XRobots/openDog/Part1/CAD/DogV3.stp

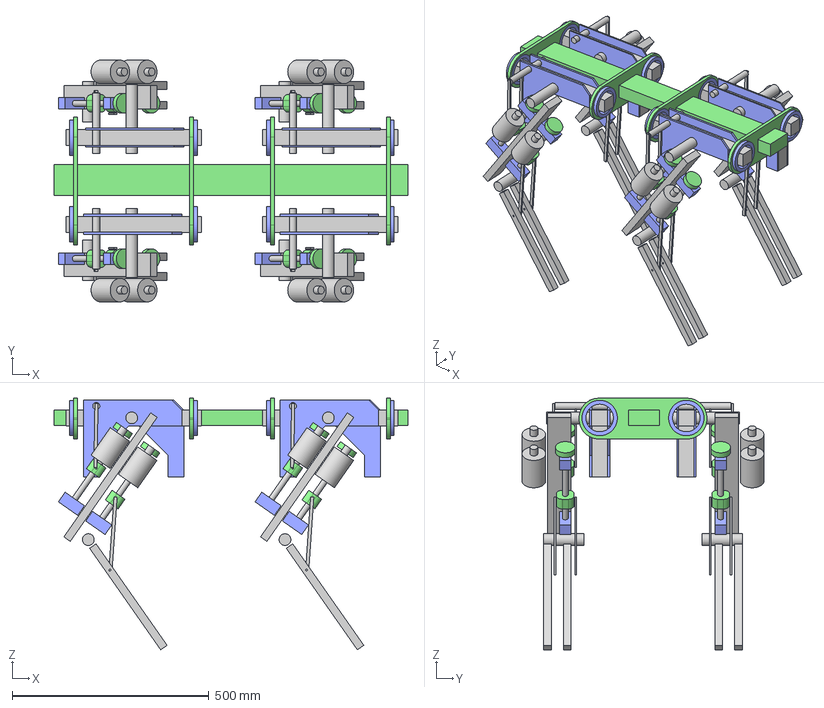
[picture p1: CAD file, 2018-05-31]
Part1/CAD/DogV3.stp
900.0 x 615.0 x 639.7 mm
slider1 x 2
slider2 x 2
lower leg x 2
hip x 2
rod2 x 2
rod1 x 2
slider1(Mirror) (1) x 2
slider2(Mirror) (1) x 2
lower leg(Mirror) (3) x 2
hip(Mirror) (3) x 2
rod2(Mirror) (1) x 2
rod1(Mirror) (1) x 2
