XRobots/openDog/Part10/bone3.stl

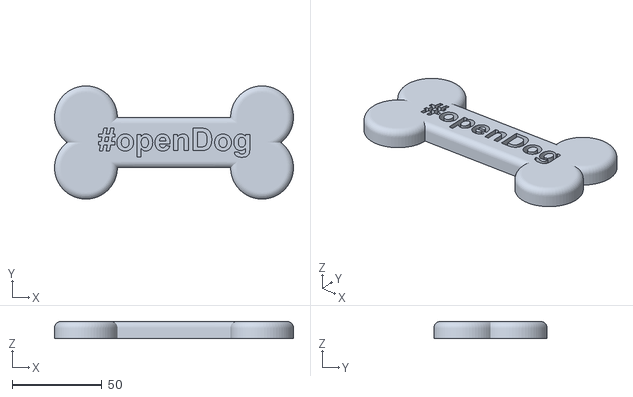
[picture p2: CAD file, 2018-09-28]
Part10/bone3.stl
133.0 x 63.0 x 9.50
