XRobots/openDog/Part15/top.stl

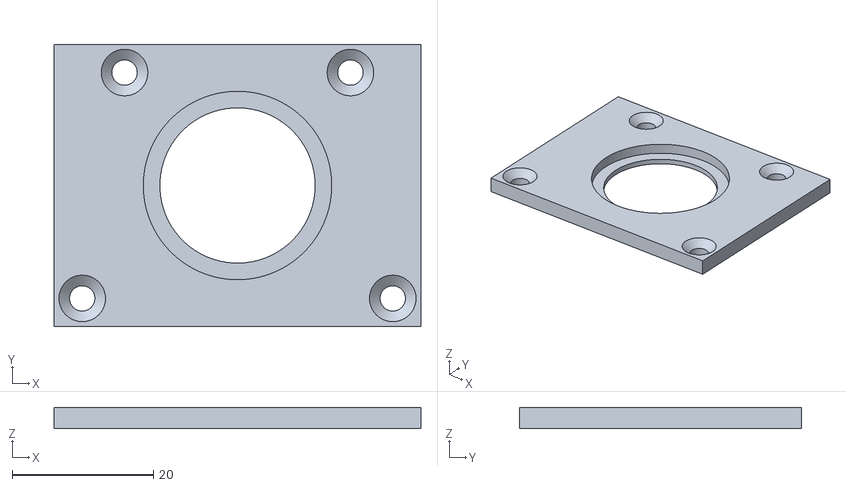
[picture p3: CAD file, 2019-03-19]
Part15/top.stl
52.0 x 40.0 x 3.00
