XRobots/openDog/Part2/CAD/Big_pulley.stl

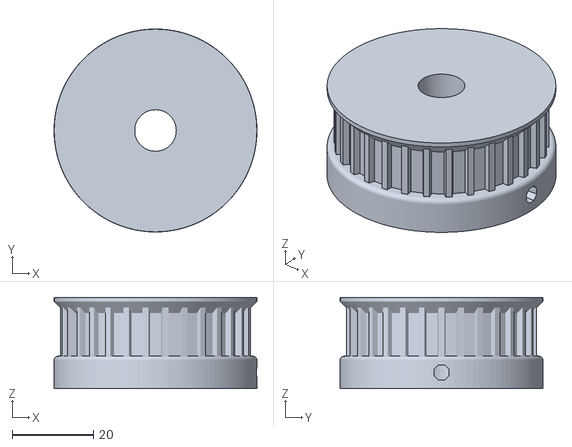
[picture p4: CAD file, 2018-07-12]
Part2/CAD/Big_pulley.stl
50.0 x 50.0 x 22.5
