XRobots/openDog/Part3/CAD/DogV4.stp

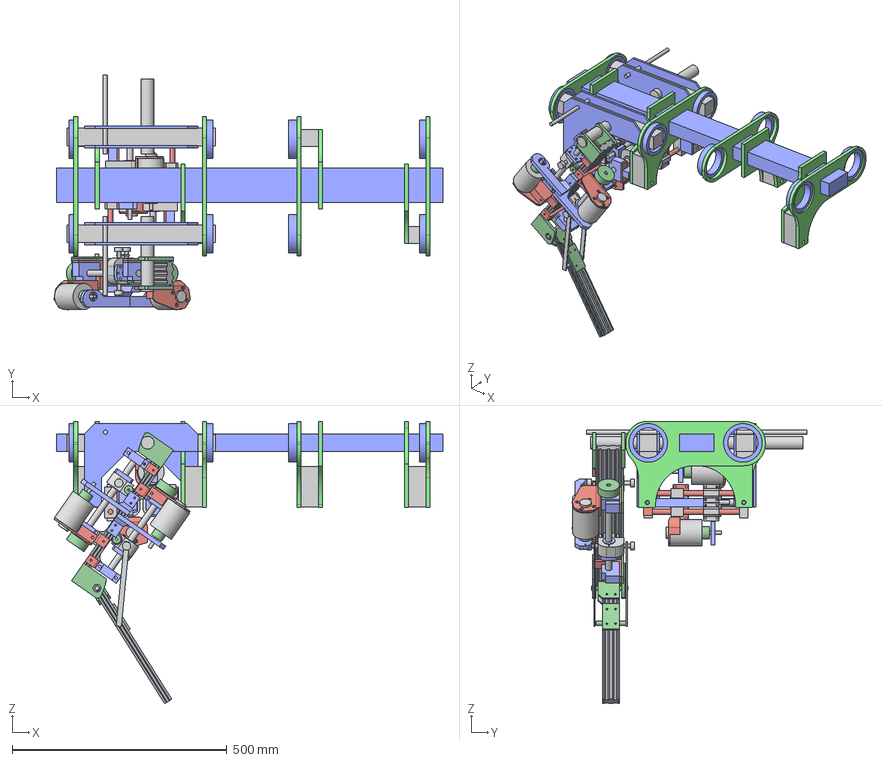
[picture p5: CAD file, 2018-06-29]
Part3/CAD/DogV4.stp
905.5 x 546.2 x 657.6 mm
hip
LINKAGE
ballNut
6020 assy
slideblock (1)
slider x 2
motor v1
motor_mount2 (1)
hip (2)
motor_mount2 (1) (1)
