XRobots/openDog/Part4/DogV4 body.stp

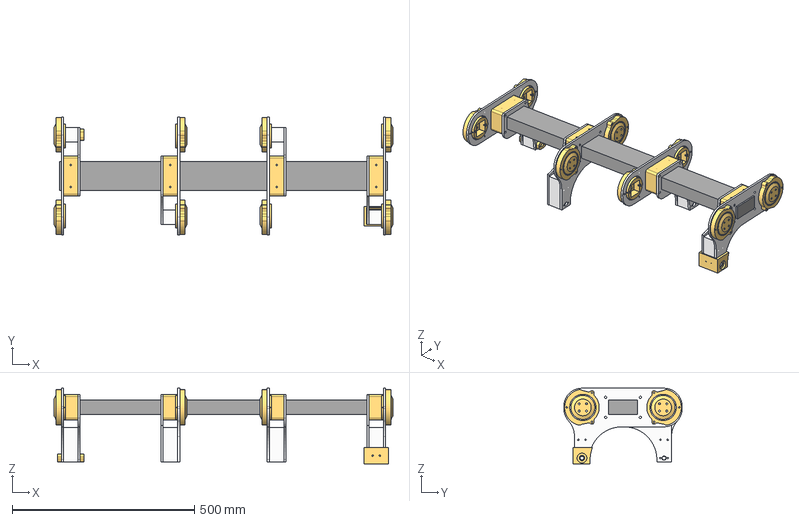
[picture p6: CAD file, 2018-07-11]
Part4/DogV4 body.stp
930.0 x 324.9 x 207.5 mm
beam_bracket
plates
4040bearing
HUBS
