XRobots/openDog/Part5/DogBody p5.stp

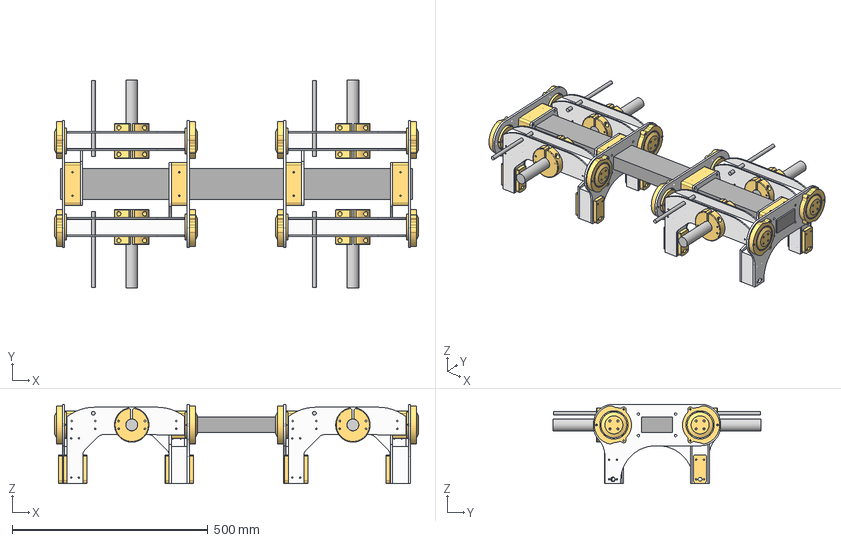
[picture p7: CAD file, 2018-07-25]
Part5/DogBody p5.stp
930.0 x 530.3 x 203.1 mm
beam_bracket
plates
4040bearing
HUBS
Hip1 x 2
Hip2 x 2
