XRobots/openDog/Part6/Leg P6.stp

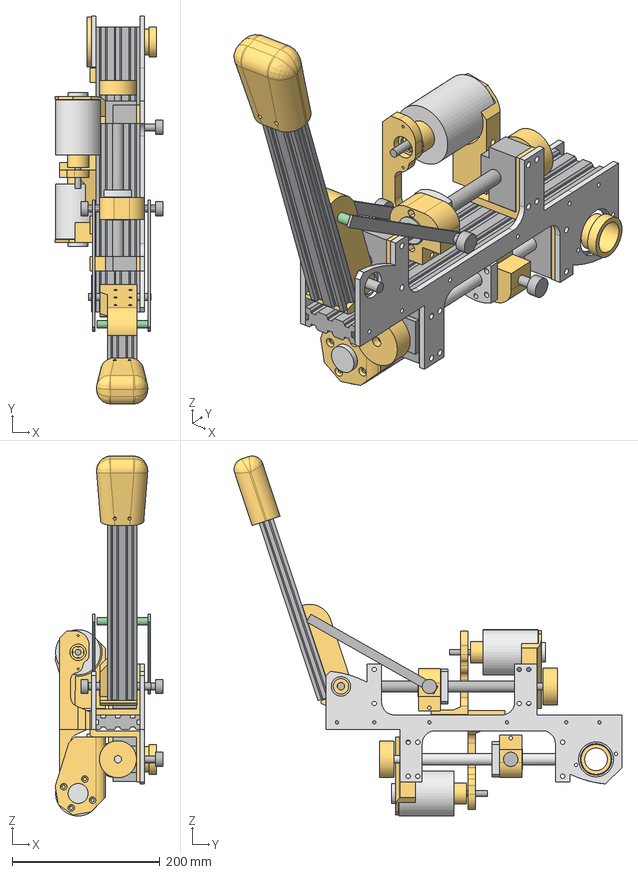
[picture p8: CAD file, 2018-08-15]
Part6/Leg P6.stp
145.6 x 524.6 x 486.9 mm
LINKAGE
ballNut
6020 assy
slideblock (1)
