XRobots/openDog/Part1/CAD/Remote.stp

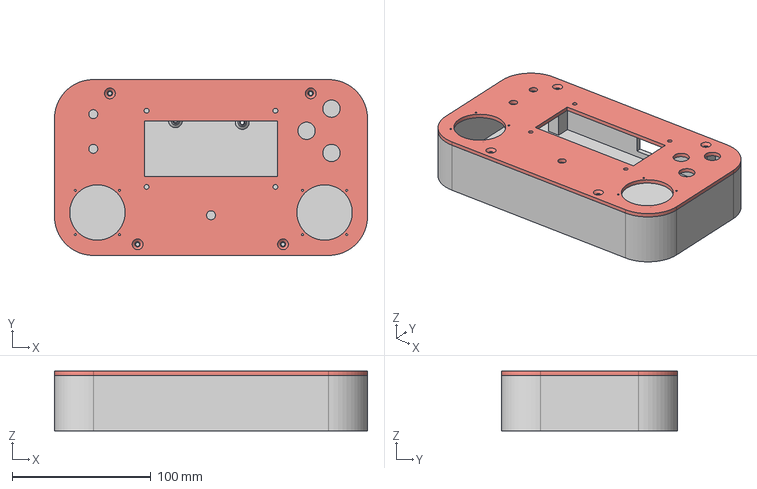
[picture p9: CAD file, 2018-05-31]
Part1/CAD/Remote.stp
226.0 x 127.0 x 43.0 mm
