XRobots/openDog/Part15/knob.stl

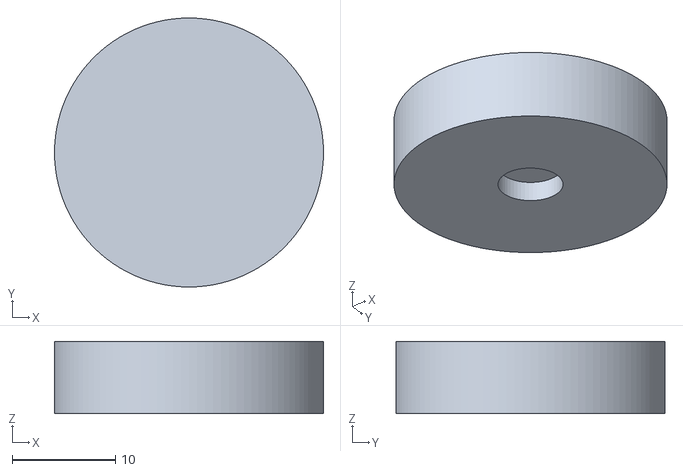
[picture p10: CAD file, 2019-03-19]
Part15/knob.stl
26.0 x 26.0 x 7.00
