XRobots/openDog/Part2/CAD/motorPulley.stl

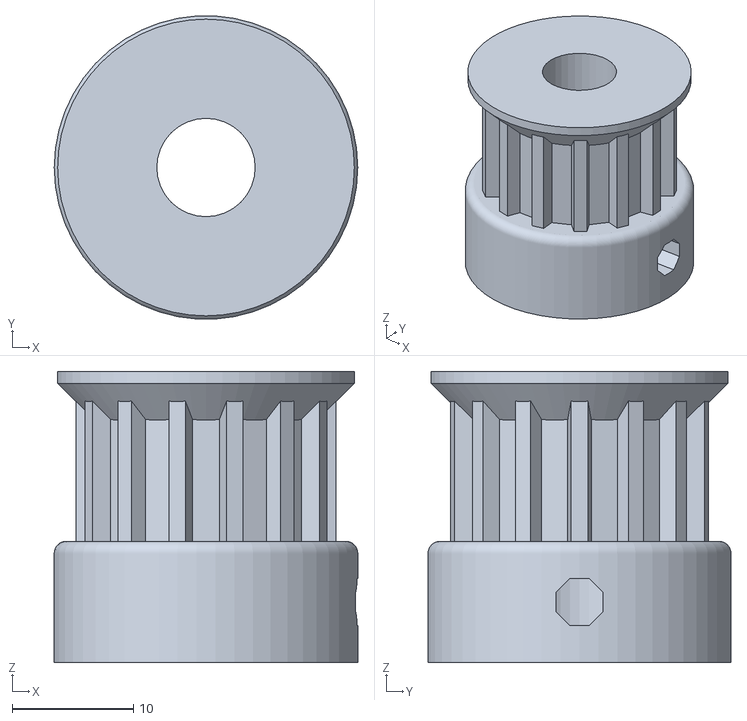
[picture p11: CAD file, 2018-07-12]
Part2/CAD/motorPulley.stl
25.0 x 25.0 x 24.0
