XRobots/openDog/Part3/CAD/linear_actuator.stp

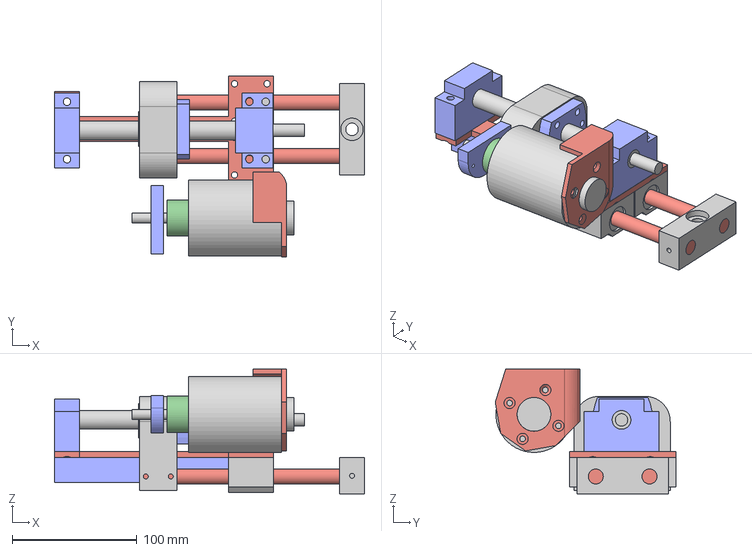
[picture p12: CAD file, 2018-06-29]
Part3/CAD/linear_actuator.stp
248.1 x 144.5 x 99.8 mm
slider
motor v1
