XRobots/openDog/Part5/linear_actuator P5.stp

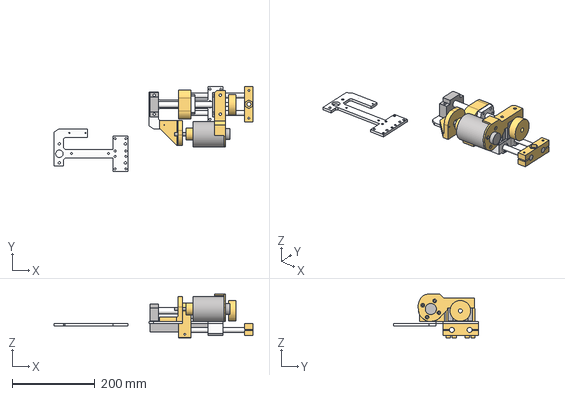
[picture p13: CAD file, 2018-07-25]
Part5/linear_actuator P5.stp
482.1 x 204.8 x 106.3 mm
slider
motor v1
