XRobots/openDog/Part15/bottom.stl

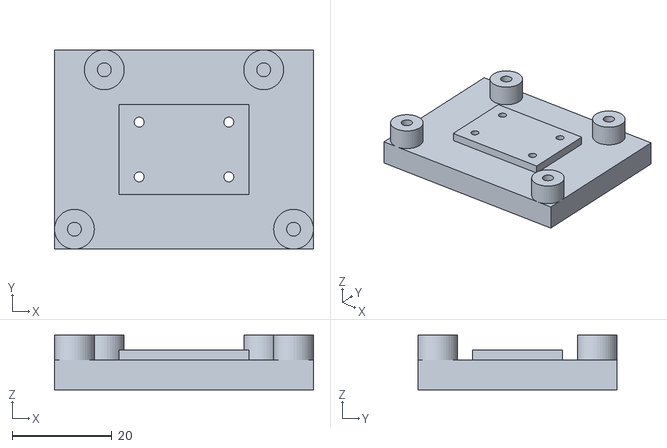
[picture p14: CAD file, 2019-03-19]
Part15/bottom.stl
52.0 x 40.0 x 11.0
