XRobots/openDog/Part2/CAD/Leg_test01.stp

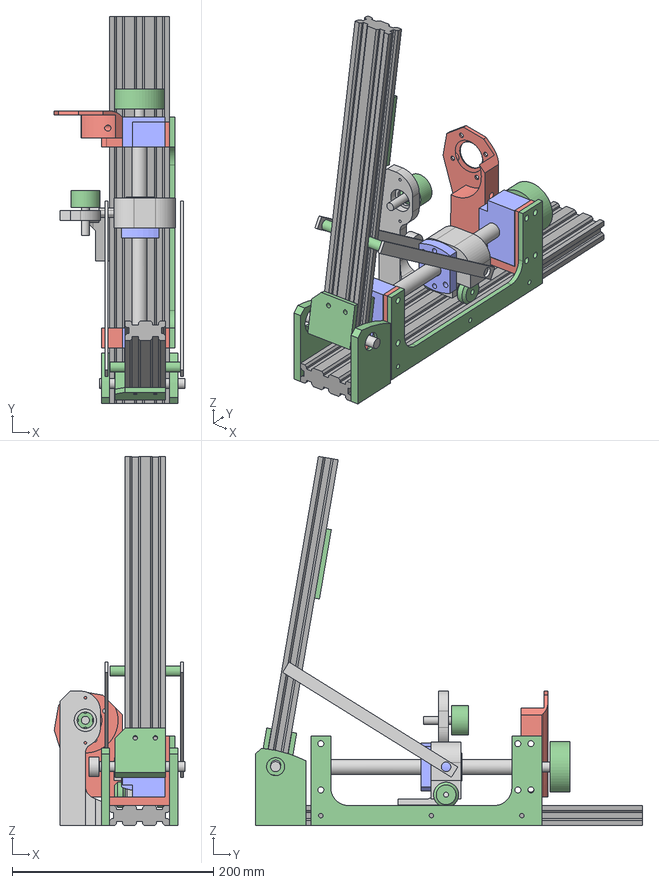
[picture p15: CAD file, 2018-06-15]
Part2/CAD/Leg_test01.stp
129.9 x 385.0 x 367.3 mm
LINKAGE
ballNut
6020 assy
