XRobots/openDog/(threads)

Thread 2 (2018-06-02):

Open Source License

IanTheEngineer, 2018-06-02:
Hi James! I'm thrilled to see your new project open-sourced on github. I have already played around a bit with your model, doing a very rudimentary port of it into [URDF format](http://wiki.ros.org/urdf) and displaying it in RViz, ROS' visualization tool: https://github.com/IanTheEngineer/opendog_robot

It occurred to me while working with your models, that there isn't a license for your work. Without an open source license, it's not clear who can utilize, modify, and redistribute opendog, and how credit should be attributed to you. I'd recommend choosing a license, adding your copyright to it, and placing it in the openDog repository to be distributed with your code and models:

https://choosealicense.com/

For what it's worth, the licenses for code distributed the ROS ecosystem are typically permissive licenses like BSD, MIT, or Apache 2.0: http://wiki.ros.org/DevelopersGuide#Licensing

jantje, 2018-06-02:
If I understood correctly from james his video the licence is GNU GPLv3

XRobots, 2018-06-02:
@IanTheEngineer looks great - I should really take the time to learn about ROS, but maybe I will once basic functionality is there.

I'm probably re-drawing the whole thing though from the feel up as I actually design the detail of where bearings and hinges etc go, although it's the same overall concept.

@jantje @IanTheEngineer yes the license is 'true open source' so anyone can modify and commercialise   the design if they wish - same as RapRap 3D printers. I think GPL3 fits as that's what Lulzbot are using for printer hardware and software: https://www.lulzbot.com/learn/tutorials/licensing-recommendations

Also they have a copyright license, which is I guess for the 'likeness' of the printer since that should only cover creative works?.

Obviously Creative Commons licensing is used a lot on Thingiverse , but my understanding is that a copyright license can't cover functionality unless it's inherent in the look of it.

jantje, 2018-06-02:
I hate licences so I'm not the specialist but if I understood correctly you want people that modify the code to share their modifications. In that case (based on the link above) GNU GPLv3 is the way to go

IanTheEngineer, 2018-06-03:
> I hate licences so I'm not the specialist

I agree with the sentiment that the license shouldn't matter, but rather just the contribution to open source itself. Alas, [no license is in fact a license only to the original author](https://choosealicense.com/no-permission/), which is generally avoided by the open source communuty.

> yes the license is 'true open source' so anyone can modify and commercialise the design if they wish - same as RapRap 3D printers. I think GPL3 fits...

I think your assessment that GPL3 is a better fit than Creative Commons for this CAD/software hybrid project is a good one. There are plenty of open source software projects in the world using GPL3, and Creative Commons itself [recommends against](https://creativecommons.org/faq/#can-i-apply-a-creative-commons-license-to-software) using their license for software.

> I should really take the time to learn about ROS, but maybe I will once basic functionality is there.

I would be happy to help in your efforts to learn ROS, and add it to your robots. I've been using it for years in grad school, professionally, and as a hobbyist. Most recently, I emulated my employer's [robot arm using Gazebo](https://github.com/RethinkRobotics/sawyer_simulator) for educators & researchers. The learning curve is unfortunately a bit steep, but the rewards are substantial: robotics math toolkits, pre-calculated transforms, path planning algorithms, physics simulators, inter-process communication, sensor drivers, etc. Plus a robust open source community :)

Feel free to contact me via email ian@ianthe.engineer whenever you're ready to dive into ROS.

XRobots, 2018-06-03:
Thanks @IanTheEngineer  I've added a statement to say 'All CAD and code is licensed under GPL3: https://www.gnu.org/licenses/gpl-3.0.en.html' in each README for RObotX and openDog.

rjw57, 2018-06-05:
That's great, @XRobots, I'll open a PR which adds a "COPYING" file to the repo. Then GitHub will mark the repo as being GPL3.

rjw57, 2018-06-05:
@XRobots PR open at #4.

Closed 2018-06-05.

Thread 3 (2018-06-05):

How about actual source - Fusion 360 files?

soswow, 2018-06-05:

XRobots, 2018-06-05:
I considered it, but I'd like to avoid proprietary formats of possible. Also it all gets redrawn in detail from part 2 onward

soswow, 2018-06-05:
I believe Fusion 360 has a way of sharing a link to a project. Have you thought about sharing that? I think it can be used to download latest/current version. It would be cool to have all the linkages if someone decides to contribute.

unrealwill, 2018-07-03:
Would it be possible to have the file exported as URDF (the standard for use in robotic simulation), I'm not sure the information about the position, direction and type of the joints is conserved in the current STP format.

XRobots, 2018-07-03:
What application does a URDF come from? Fusion doesn't have an export for that

unrealwill, 2018-07-03:
I'm not familiar with Fusion 360, there probably are some exporter plug-in.
Solidworks should be able to do it : http://wiki.ros.org/sw_urdf_exporter/Tutorials

soswow, 2018-07-03:
Btw, I have a feeling this could be a request in its own issue. This issue is about source CAD files anyway.

soswow, 2018-07-03:
@XRobots feel free to close this one if you are not planning on adding f3b files

unrealwill, 2018-07-03:
@soswow Sorry for squatting your thread, it was still open and thought it was related, as it uses info that are lost without the fusion 360 source files.
@XRobots It seems to not be as simple as I thought it would be(as the fusion 360 -> solidworks seems to go through the STP format which supposedly lose joint info). So it probably deserve its own issue. There seems to be a path in two steps using unofficial software : Fusion 360 -> SDF -> URDF.

We should be able to do  Fusion 360 -> SDF using https://github.com/Roboy/SDFusion
Then SDF -> URDF using sdf2urdf.py of https://github.com/andreasBihlmaier/pysdf

Alternatively it may be faster to just create the urdf manually, (and eventually optimize it by replacing parts by their convex hulls).

unrealwill, 2018-07-03:
I created a simplified URDF manually to import in pybullet. You can see more here :
https://github.com/GistNoesis/OpenDogSimulator

XRobots, 2018-07-03:
Looks good, I'll give you/it a shout-out in Part 4 if that's ok with you!

unrealwill, 2018-07-03:
@XRobots No problem

AlexFielder, 2018-09-16:
Just noticed this thread in my emails (apologies if this has been answered elsewhere). Here's a direct converter from Fusion 360 to URDF: https://github.com/syuntoku14/fusion2urdf

XRobots, 2018-09-17:
Here you go: https://a360.co/2xuglDI

XRobots, 2018-09-17:
I clicked on 'close' instead of 'comment' btw

ZgnDaniel, 2019-02-14:
Hello James !

Is there any chance to update the link for the fusion 360 files ?
Old link does not work anymore.
Thank you!

XRobots, 2019-02-14:
Try this: https://a360.co/2D433Uv

Thread 6 (2018-06-06):

Parts list?

guohc, 2018-06-06:
I would like to know where you got that fancy joystick, or what I should search for.
Maybe you can post the complete parts list here as well
Thanks!

XRobots, 2018-06-06:
It was this: https://www.ebay.co.uk/itm/3-axis-Joystick-Potentiometer-JH-D300X-R1-5K-220-ohm-4D-Joystick/263576633044

complete parts list is pretty much unknown at the moment, and some of the parts shown are subject to change

mrbesen, 2020-02-05:
seems like the link is broken.
Here is one i found: https://ebay.us/hQ4Z3n
with this search: `3 axis Joystick JH D300X 5K-220ohm`

Thread 8 (2018-09-05):

Replacing Arduinos with Jetson Tx2

Rafcin, 2018-09-05:
I'm just pondering some ideas, but could you instead run the whole robot from a Jetson Tx2 and have ROS so then you can add other sensors and having multiple programs in different languages.

XRobots, 2018-09-05:
Yes probably, there are lots of options. A fair way to go before upgrades yet though!

21brownz, 2019-03-05:
https://github.com/FRC900/2018RobotCode
this is a FIRST Robotics team's code, but they are one of if not the only team to use ROS for their competition robot. It's way over my head but maybe you guys can make sense of it and possibly use it. I'd love to see XRobots projects running ROS.

Thread 10 (2018-09-07):

ITX mount design

Gator-Boy11, 2018-09-07:
As you discussed in the video, a mini-ITX motherboard mount will be useful. However certain things like large coolers or graphics cards for vision processing might be too heavy and break the motherboard due to the frequent jerking motions of a robot taking steps. Could you maybe design it to have the motherboard mount to the front of a panel and then use a PCIe riser to mount expansion cards flat against another panel or the back of the same panel? That way vision processing could be offloaded to a graphics card freeing up the CPU without having a heavy card shaking about. The cooler issue might be trickier, but you could design a 120mm or 240mm radiator mount and use water cooling, or just use a low profile, lightweight cooler.

XRobots, 2018-09-08:
We'll see what happens here, there are are a number of other options for x86 boards. I just need something more powerful than a Rasp pi really.

Thread 12 (2018-09-22):

Code Organisation

JakeMercer, 2018-09-22:
Hi James, love the project! I just have a few suggestions on how to organise your code; a few small changes that would make contributing to the repository _much_ easier.

By organising the code into "parts" corresponding to your videos you're not really exercising the real power of Git.  Instead of having copies of the main dog INO file with each video's changes in a different directory, you should have a single file that you change and make a commit for each video you produce.  This would help clean up the repo and mean if anyone makes a pull request with useful changes to the code, it's easy for you to pull those changes into your file and don't have to manually sync those changes into files you have yet to push.

There is a useful discussion on the topic in [this StackOverflow question](https://arduino.stackexchange.com/questions/348/how-to-organize-my-arduino-projects-structure-for-easy-source-control).

There are a number of common structures that could be defined in a common header file so that if you needed to make extensions, you only have to do that in one place.

Cheers,
Jake

qazxswedcvfrtgbnhyujmkiolp, 2019-05-23:
It would make sense to make a separate branch along with each new video as a reference and continually update master (or any other branch) as any normal code project would. This would make it easy both for those watching the video, since they can "follow along" with the code, and for devs since they can benefit from Git as it's meant to be used.

mrbesen, 2020-02-05:
instead of making branches, you can just tag the latest commit of a video with "PartXX" or something.

Thread 14 (2018-10-23):

Ardunio Sketches.

IdrisTheDragon, 2018-10-23:
Hey, I don't know if you already know this trick but you should consider using multiple files for one sketch instead of having everything in one bloated source file. The Arduino IDE makes this very easy:

1.  Click the new tab button and name it however you want. It will create a second .ino file next to your original in the sketch directory, and open a new tab in the IDE.

2.  Move your functions into the other files it creates, these functions are accessible in the main sketch file the same as if they where in the main file, no complex imports needed.

3. Save hours of scrolling through the big file when you could just switch tabs to find the function/bit of code you want.

It's not very well documented online, but it is sooo useful for code organisation.

p.s. please start using git properly... you could add tags to mark the code commit for each episode. Then note this down in the README for non git users to understand, much nicer than partX folders...

IdrisTheDragon, 2018-10-23:
Also https://create.arduino.cc/editor apparently this is a thing.

Closed 2018-10-23.

Thread 15 (2018-11-01):

The attempt to avoid dividing by zero is incorrect

tspink, 2018-11-01:
https://github.com/XRobots/openDog/blob/98050a469b15a26739f628e98b33c294fa8206f7/Part11/Dog011/Dog011.ino#L391

The check you have on Line 389, to avoid dividing by zero on Line 391 is incorrect.  You are ensuring that the **dividend** (i.e. the number to be divided, X) is not zero, when you should be ensuring that the **divisor**  (i.e. the number that divides the dividend, Z) is not zero.

Therefore the check should be to ensure that Z does not become zero.  There is nothing wrong with the dividend (in this case X) becoming zero.  As the X approaches zero, so does the value of the fraction - which is correct.

(Note: this error is made in multiple places)

XRobots, 2018-11-01:
That's not where the divide by zero occurs. Z is never zero, but X and Y are zero in the centre of the travel for those axis, which means zero gets passed into the rest of the code and the trig fails elsewhere.

tspink, 2018-11-01:
OK, that's fair enough.  Maybe just extend the comment to explain this, as it's not immediately clear that's what the guard is for!

Following the flow of `X`, in the example I linked, means that if `X` is zero, `hipAngle1` becomes zero, then `sin(hipAngle1)` would be zero, leading to a divide-by-zero on the `hipHypotenuse` calculation.

Thanks for clarifying!
Tom

Thread 17 (2018-11-09):

Is there a BOM file for this robot?

wei1224hf, 2018-11-09:
Is there a BOM (Bill of material) file for this ?
If I want to do it in my home , I have to buy some stuff I think, like aluminum profile and bolt and nut.
But I don't know the size of each .

And , Great Dog , thank you for your share!

XRobots, 2018-11-09:
No there isn't, and it's subject to change as I go through the development. All the extrusion is shown in the CAD though

Bostwickenator, 2019-06-06:
I'd love to see a BOM as well. Simple things like what joysticks are in the controller, which motors you picked would be really handy to have in one place.

vexvoltage, 2019-12-19:
Hi,

The drive boards are: https://odriverobotics.com/shop/odrive-v36
The motors are some sort of Turnigy Aerodrive I just do not know what you are running for wattage, I would love to know more about the motor setup and choice because I have tons of 40W CAN motors.

XRobots, 2019-12-19:
It's these: https://hobbyking.com/en_us/turnigy-aerodrive-sk3-6374-149kv-brushless-outrunner-motor.html?___store=en_us

I'm running them on 24v at the moment, so about 1/4 of the rated max power, but that may change.

vexvoltage, 2019-12-19:
I am sure this is probably not the most appropriate place to discuss this, but are you running into power issues from them not giving out enough? Is there are reason you would change the motors to something bigger/Smaller?

XRobots, 2019-12-19:
There's more than enough power, I might go to 36 or 48v thought so they go faster, but in reality I'd change the belt drive ratio to the ball screw to 1:1 first.

vexvoltage, 2019-12-19:
What is your ideal RPM you want to be moving these ball screws at? Also do you know how much load is actually put on these motors from weight/ Friction/ other forces?

XRobots, 2019-12-19:
I don't actually know, most of what I do is trial and error. They could do with being quicker though

vexvoltage, 2019-12-19:
Sorry for asking so many questions, but would you go through and re-build all 12 so they are kept the same, or would you do like leg only upgrades? If there is a better format to ask these questions let me know.

XRobots, 2019-12-19:
That is uncertain at this stage. It's possible I might just try a 36v battery first also, haven't really decided.

Thread 21 (2019-06-25):

IMU data reads

alanbithell, 2019-06-25:
In your function dmpDataReady, instead of setting IMUdataReady = 1, try incrementing the value, then in your main loop, read the data IMUdataReady times to clear the FIFO and decrement that counter with each loop.
This will prevent fifo overflow and give you the most recent value from the IMU.
I would have added this to code and created a PR but part 19 isn't up.

```
void dmpDataReady() {
    IMUdataReady++;
}
```

...main loop...
```
// IMU test
while (IMUdataReady > 0) {
    readAngles();
    IMUdataRead--;
}
```

XRobots, 2019-06-25:
According to the example code it'll read multiple values out of the FIFO when the function is called anyway, so it should never leave anything behind.

alanbithell, 2019-06-25:
Ah, fair enough.
Perhaps then for your use case, you don’t really need a FIFO buffer, you just want the latest value.
Could you disable the FIFO? Set the rate to max and just manually read the values in your main loop? That way you’ll always get the newest value and won’t need to read multiple times from the FIFO at a lower rate.

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

Thread 24 (2020-04-20):

Code Releases

pmaasz, 2020-04-20:
Working with releases can optimize merging code from different parts/episodes. The code would not diverge too much from each part as every PR would be against the current and same code base. Redundant efforts are eradicated and productivity improved. Confirmed builders could be instated as maintainers to help overview code changes (this bit has nothing to do with this issue). All in all those are only suggestions.

Thread 26 (2020-12-21):

"Incomplete" STP files? On OpenDog Part1 Remote STP files.

Bin0ry, 2020-12-21:
I'm seeing the bottom STP file for the "remotes case" but I don't see the top where the joysticks are located with the switches. Could this please be added :) <3

Bin0ry, 2020-12-21:
Sorry it looks like for some reason when trying to convert these into STL files, I ran into issues. Viewing the STP file alone seems to show the top part. I guess I'll figure this out.

Closed 2020-12-21.

Thread 28 (2021-07-28):

Suggestion - Upper leg and belt tension

mungewell, 2021-07-28:
Very impressed with the work that you are doing, and enjoy watching the videos.

In the latest you had the issue of maintaining belt tension when the leg under a lot of force/weight... since the force direction is asymmetric (ie always in a particular direction) can you create a upper leg which deliberately flexes a little and creates more tension in the belt as it does.

This maybe could use a cam to push on the tensioner as the leg flexes. As a side effect it would create a little more leg springiness by using the belt elasticity.
