XRobots/openDog/part17/Dog017b/Interpolation.ino

// ****** Interpolation functions **************

int interpolationZ(int input, int duration) {

    static int interpolationFlag = 0;  
    static int savedValue;

      if (input != savedValue) {   // check for new data
          interpolationFlag = 0;
      }
      savedValue = input;          // bookmark the old value  
    
      if (interpolationFlag == 0) {                                        // only do it once until the flag is reset
          myRampZ.go(input, duration, LINEAR, ONCEFORWARD);              // start interpolation (value to go to, duration)
          interpolationFlag = 1;
      }
    
      int output = myRampZ.update(); 

      return output;  
}

int interpolationY(int input, int duration) {

    static int interpolationFlag = 0;  
    static int savedValue;

      if (input != savedValue) {   // check for new data
          interpolationFlag = 0;
      }
      savedValue = input;          // bookmark the old value  
    
      if (interpolationFlag == 0) {                                        // only do it once until the flag is reset
          myRampY.go(input, duration, LINEAR, ONCEFORWARD);              // start interpolation (value to go to, duration)
          interpolationFlag = 1;
      }
    
      int output = myRampY.update(); 

      return output;  
}

int interpolationX(int input, int duration) {

    static int interpolationFlag = 0;  
    static int savedValue;

      if (input != savedValue) {   // check for new data
          interpolationFlag = 0;
      }
      savedValue = input;          // bookmark the old value  
    
      if (interpolationFlag == 0) {                                        // only do it once until the flag is reset
          myRampX.go(input, duration, LINEAR, ONCEFORWARD);              // start interpolation (value to go to, duration)
          interpolationFlag = 1;
      }
    
      int output = myRampX.update(); 

      return output;  
}
