XRobots/openDog/(commit log)

2018-05-31 Part 1 files
    [DogV3.stp, Remote.stp]
2018-06-15 Files for part 2
    [Leg_test01.stp]
2018-06-29 files for part 3
    [DogV4.stp, linear_actuator.stp]
2018-07-11 Part 4 files added
    [DogV4 body.stp]
2018-07-12 added the T5 Pulley files
    [Big_pulley.stl, motorPulley.stl]
2018-07-25 Part 5 files
    [DogBody p5.stp, linear_actuator P5.stp]
2018-08-15 Part 6 files
    [Leg P6.stp]
2018-08-29 CAD assembly for Part 7
2018-09-28 Added openDog bone
    [bone3.stl]
2018-10-17 Part 12 code samples
    [leg sequence.xlsx]
2019-03-19 Test files for part 14 and 15
    [bottom.stl, knob.stl, top.stl]
